Arrakark/Draco/hardware/pin_define.txt

#DEFINE FIRE_A 22
#DEFINE FIRE_B 23
#DEFINE FIRE_C 24
#DEFINE TEST_EN_A 25
#DEFINE TEST_EN_B 26
#DEFINE TEST_EN_C 27

#DEFINE LORA_NSS 28
#DEFINE SD_NSS 29

#DEFINE LVL_EN 36

#DEFINE SERVO1 49
#DEFINE SERVO2 48
#DEFINE SERVO3 47
#DEFINE SERVO4 46
#DEFINE SERVO5 45
#DEFINE SERVO6 44
#DEFINE SERVO7 43
#DEFINE SERVO8 42
#DEFINE SERVO9 41
#DEFUBE SERVI10 40

#DEFINE MAGNET_INT 62
#DEFINE ACCEL_INT1 63
#DEFINE ACCEL_INT2 64

DDRJ = DDRJ | B00110000;
//PORTJ = B10101000; // sets digital pins 7,5,3 HIGH
//camera not in Arduino ide; must use port manipulation to read and write camera values. Write functions for these plz.
//CAM_LED PJ3 
//CAM_PHOTO PJ4 
//CAM_PWR PJ5 

#DEFINE LED_RED 6
#DEFINE LED_YELLOW 7
#DEFINE LED_GREEN 8

#DEFINE LORA_RST 59
#DEFINE VBAT_1S 58
#DEFINE VBAT_2S 57
#DEFINE TEST_READ_C 56
#DEFINE TEST_READ_B 55
#DEFINE TEST_READ_A 54

#DEFINE LORA_INT 2
#DEFINE GPS_INT 3

//GPS is connected to Serial1 not Serial

#DEFINE TEST_STAND_DOUT 68
#DEFINE TEST_STAND_SCK 69
