Arrakark/Draco/hardware/DracoPowerBudget.xlsx

Project Draco Power Budget
Battery Rail
Component | Quantity | Current Draw (mA) | Total Current (mA) | Voltage (V) | Power (mW) | Notes
HV Servos | 10 | 1200.00 | 12000 | 8.4 | 100800
5.0v Rail | 1 | 475.86 | 475.8556548 | 8.4 | 3997.1875
Sum |  |  | 12475.86 |  | 104797.1875
5.0V Rail
Component | Quantity | Current Draw (mA) | Total Current (mA) | Voltage (V) | Power (mW) | Notes
Test Servo | 10 | 0 | 0 | 5 | 0 | If you were to plug test servos in
Atmega 2560 | 1 | 200 | 200 | 5 | 1000 | Main MCU
TXS010 | 1 | 1 | 1 | 5 | 5 | Level Shifter
SD Card | 1 | 100 | 100 | 5 | 500
3.3V Rail | 1 | 143.55 | 143.55 | 5 | 717.75
LEDs | 3 | 5 | 15 | 5 | 75
Camera | 1 | 150 | 150 | 6 | 900
Sum |  |  | 609.55 |  | 3197.75
3.3V Rail
Component | Quantity | Current Draw (mA) | Total Current (mA) | Voltage (V) | Power (mW) | Notes
RFM95HW | 1 | 100 | 100 | 3.3 | 330 | LORA Radio
SAM-M8Q | 1 | 67 | 67 | 3.3 | 221.1 | GPS
BMX055 | 1 | 6 | 6 | 3.3 | 19.8 | IMU
MS5607 | 1 | 1 | 1 | 3.3 | 3.3
Sum |  |  | 174 |  | 574.2
Notes
5V Imax is 3.5A
3.3V Imax is 1A
