Arrakark/Draco/(list of files, drawings)

Other design files:
hardware/Draco.dsn
