Arrakark/Draco/hardware/Draco.kicad_pcb

## KiCad design hardware/Draco.kicad_pcb (2018-03-10)

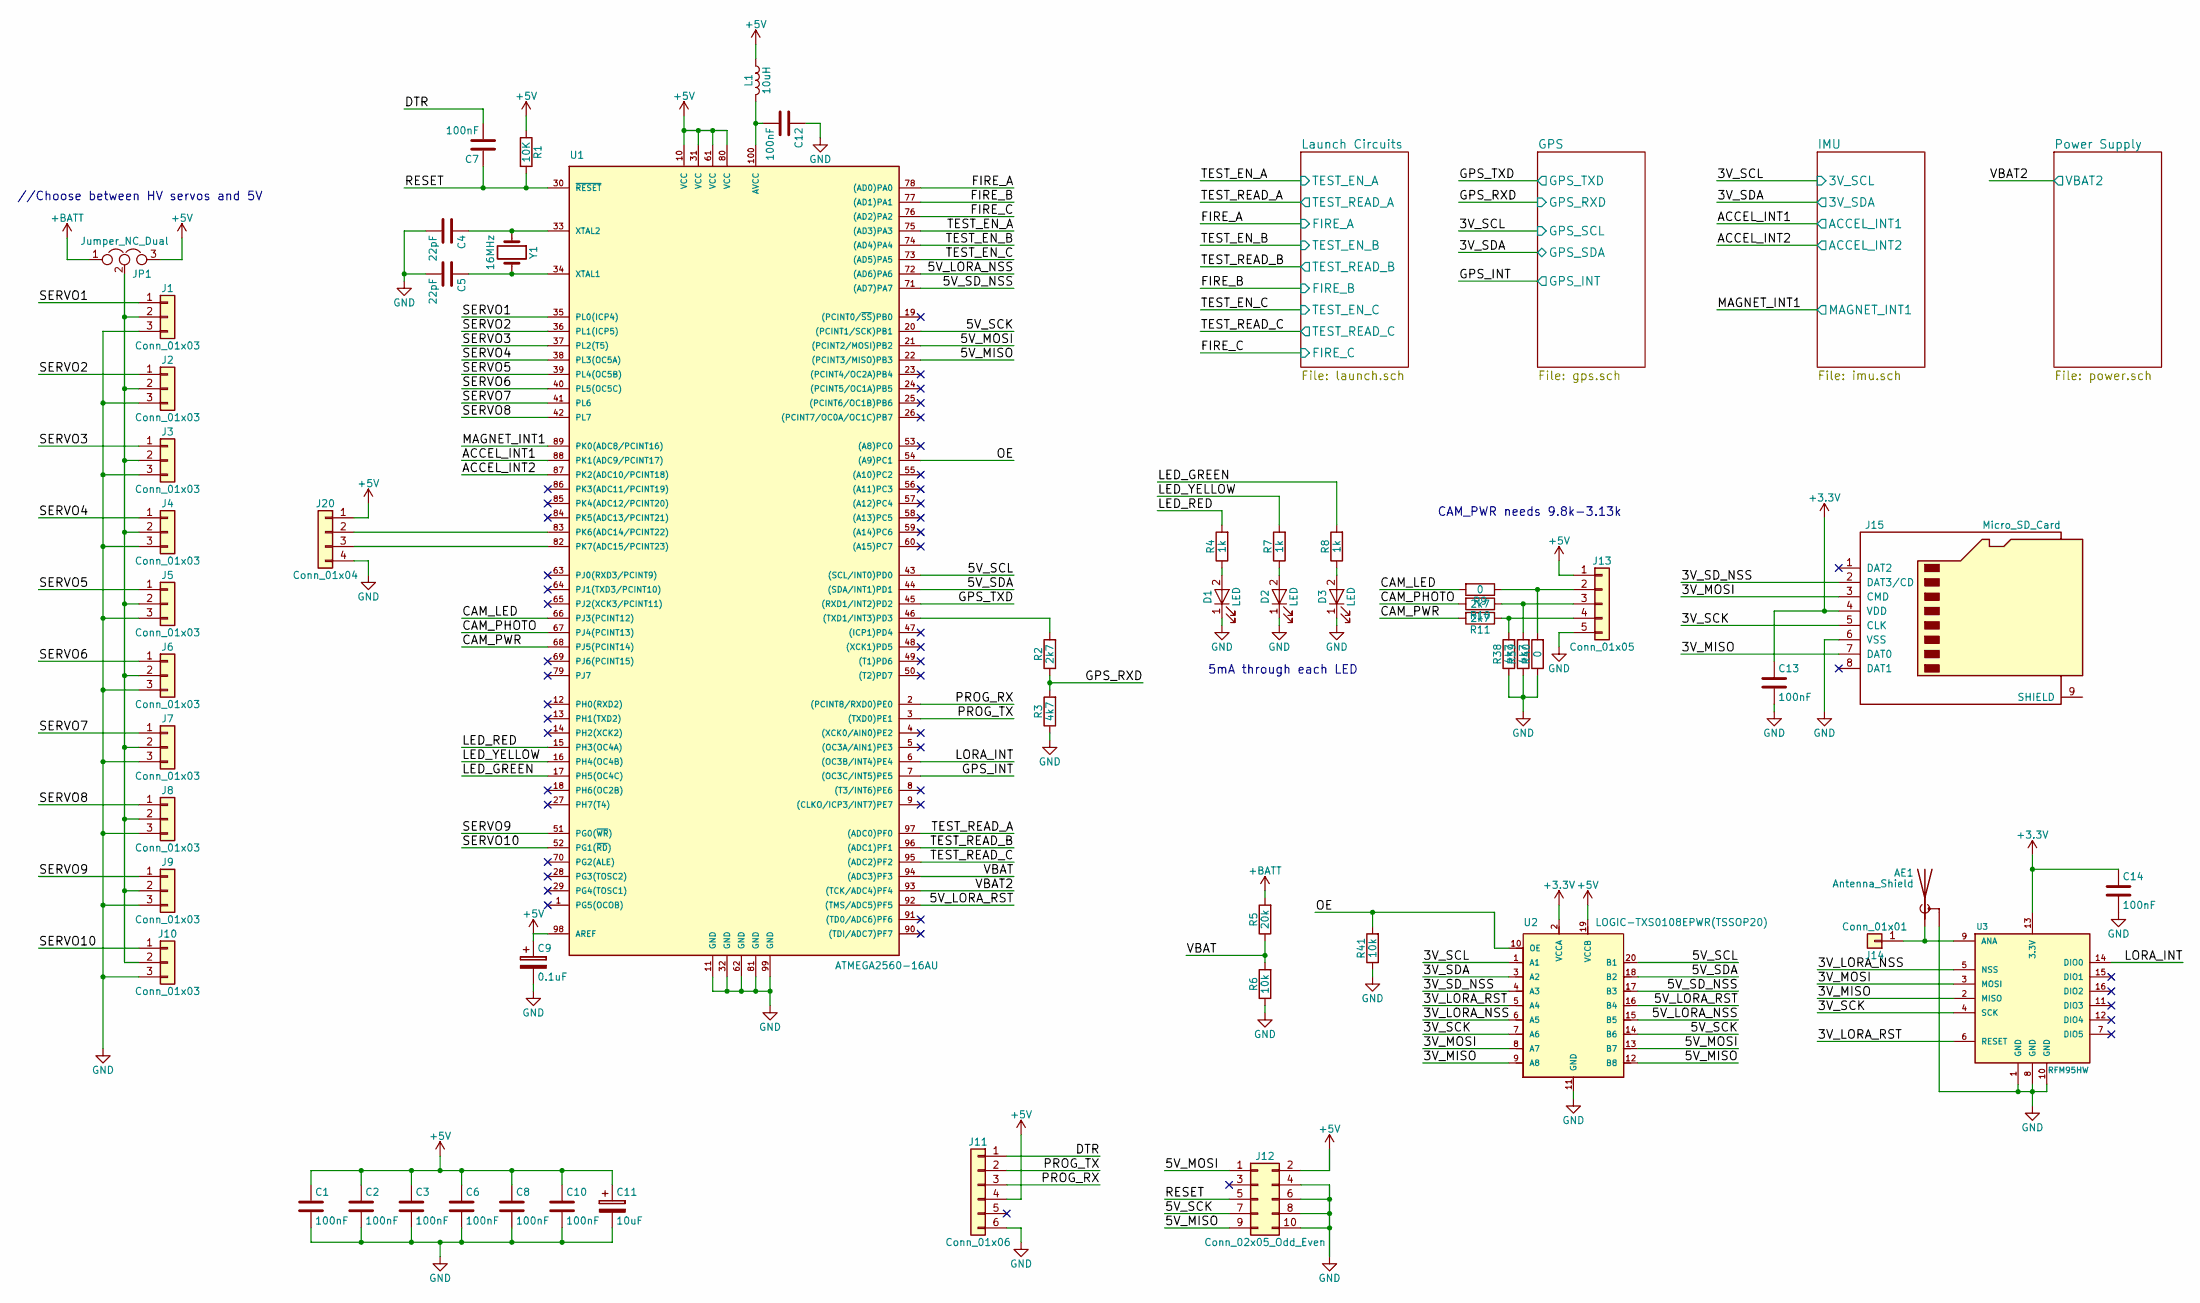
[picture p1: schematic Draco.sch]

Parts:
AE1: Antenna_Shield; U.FL-R-SMT
C1, C2, C3, C6, C7, C8, C10, C12, C13, C14: 100nF; C_0805
C4, C5: 22pF; C_0805
C9: 0.1uF; C_0805
C11: 10uF; C_0805
D1, D2, D3: LED; LED_0805
J1, J2, J3, J4, J5, J6, J7, J8, J9, J10: Conn_01x03; Pin_Header_Straight_1x03_Pitch2.54mm
J11: Conn_01x06; Socket_Strip_Straight_1x06_Pitch2.54mm
J12: Conn_02x05_Odd_Even; Pin_Header_Straight_2x05_Pitch2.54mm
J13: Conn_01x05; JST_XH_B05B-XH-A_05x2.50mm_Straight
J14: Conn_01x01; Pin_Header_Straight_1x01_Pitch2.54mm
J15: Micro_SD_Card; microSD_Card_Receptacle_Wuerth_693072010801
J20: Conn_01x04; JST_XH_B04B-XH-A_04x2.50mm_Straight
JP1: Jumper_NC_Dual; Pin_Header_Straight_1x03_Pitch2.54mm
L1: 10uH; L_0805
R1: 10K; R_0805
R2, R10, R11: 2k7; R_0805
R3, R38, R39: 4k7; R_0805
R4, R7, R8: 1k; R_0805
R5: 20k; R_0805
R6, R41: 10k; R_0805
R9, R40: 0; R_0805
U1: ATMEGA2560-16AU; TQFP-100_14x14mm_Pitch0.5mm
U2: LOGIC-TXS0108EPWR(TSSOP20); SSOP-20
U3: RFM95HW; Hopref_RFM9XW_SMD
Y1: 16MHz; Crystal_SMD_HC49-SD

Connections:
+5V: C1.1, C2.1, C3.1, C6.1, C8.1, C9.1, C10.1, C11.1, J11.4, J12.2, J13.1, J20.1, JP1.3, L1.1, R1.1, U1.10 (VCC), U1.31 (VCC), U1.61 (VCC), U1.80 (VCC), U1.98 (AREF), U2.19 (VCCB); also elsewhere on the board
+BATT: JP1.1, R5.2; also elsewhere on the board
/3V_LORA_NSS: U2.6 (A5), U3.5 (NSS)
/3V_LORA_RST: U2.5 (A4), U3.6 (RESET)
/3V_MISO: J15.7 (DAT0), U2.9 (A8), U3.2 (MISO)
/3V_MOSI: J15.3 (CMD), U2.8 (A7), U3.3 (MOSI)
/3V_SCK: J15.5 (CLK), U2.7 (A6), U3.4 (SCK)
/3V_SCL: U2.1 (A1); also elsewhere on the board
/3V_SDA: U2.3 (A2); also elsewhere on the board
/3V_SD_NSS: J15.2 (DAT3/CD), U2.4 (A3)
/5V_LORA_NSS: U1.72 ((AD6)PA6), U2.15 (B5)
/5V_LORA_RST: U1.92 ((TMS/ADC5)PF5), U2.16 (B4)
/5V_MISO: J12.9, U1.22 ((PCINT3/MISO)PB3), U2.12 (B8)
/5V_MOSI: J12.1, U1.21 ((PCINT2/MOSI)PB2), U2.13 (B7)
/5V_SCK: J12.7, U1.20 ((PCINT1/SCK)PB1), U2.14 (B6)
/5V_SCL: U1.43 ((SCL/INT0)PD0), U2.20 (B1)
/5V_SDA: U1.44 ((SDA/INT1)PD1), U2.18 (B2)
/5V_SD_NSS: U1.71 ((AD7)PA7), U2.17 (B3)
/ACCEL_INT1: U1.88 (PK1(ADC9/PCINT17)); also elsewhere on the board
/ACCEL_INT2: U1.87 (PK2(ADC10/PCINT18)); also elsewhere on the board
/CAM_LED: R9.2, U1.66 (PJ3(PCINT12))
/CAM_PHOTO: R10.2, U1.67 (PJ4(PCINT13))
/CAM_PWR: R11.2, U1.68 (PJ5(PCINT14))
/DTR: C7.2, J11.1
/FIRE_A: U1.78 ((AD0)PA0); also elsewhere on the board
/FIRE_B: U1.77 ((AD1)PA1); also elsewhere on the board
/FIRE_C: U1.76 ((AD2)PA2); also elsewhere on the board
/GPS_INT: U1.7 ((OC3C/INT5)PE5); also elsewhere on the board
/GPS_RXD: R2.1, R3.2; also elsewhere on the board
/GPS_TXD: U1.45 ((RXD1/INT2)PD2); also elsewhere on the board
/LED_GREEN: R8.2, U1.17 (PH5(OC4C))
/LED_RED: R4.2, U1.15 (PH3(OC4A))
/LED_YELLOW: R7.2, U1.16 (PH4(OC4B))
/LORA_INT: U1.6 ((OC3B/INT4)PE4), U3.14 (DIO0)
/MAGNET_INT1: U1.89 (PK0(ADC8/PCINT16)); also elsewhere on the board
/OE: R41.2, U1.54 ((A9)PC1), U2.10 (OE)
/PROG_RX: J11.3, U1.2 ((PCINT8/RXD0)PE0)
/PROG_TX: J11.2, U1.3 ((TXD0)PE1)
/RESET: C7.1, J12.5, R1.2, U1.30 (~RESET)
/SERVO1: J1.1, U1.35 (PL0(ICP4))
/SERVO2: J2.1, U1.36 (PL1(ICP5))
/SERVO3: J3.1, U1.37 (PL2(T5))
/SERVO4: J4.1, U1.38 (PL3(OC5A))
/SERVO5: J5.1, U1.39 (PL4(OC5B))
/SERVO6: J6.1, U1.40 (PL5(OC5C))
/SERVO7: J7.1, U1.41 (PL6)
/SERVO8: J8.1, U1.42 (PL7)
/SERVO9: J9.1, U1.51 (PG0(~WR~))
/SERVO10: J10.1, U1.52 (PG1(~RD~))
/TEST_EN_A: U1.75 ((AD3)PA3); also elsewhere on the board
/TEST_EN_B: U1.74 ((AD4)PA4); also elsewhere on the board
/TEST_EN_C: U1.73 ((AD5)PA5); also elsewhere on the board
/TEST_READ_A: U1.97 ((ADC0)PF0); also elsewhere on the board
/TEST_READ_B: U1.96 ((ADC1)PF1); also elsewhere on the board
/TEST_READ_C: U1.95 ((ADC2)PF2); also elsewhere on the board
/VBAT: R5.1, R6.2, U1.94 ((ADC3)PF3)
/VBAT2: U1.93 ((TCK/ADC4)PF4); also elsewhere on the board
GND: AE1.2 (Shield), C1.2, C2.2, C3.2, C4.2, C5.2, C6.2, C8.2, C9.2, C10.2, C11.2, C12.1, C13.2, C14.2, D1.1 (K), D2.1 (K), D3.1 (K), J1.3, J2.3, J3.3, J4.3, J5.3, J6.3, J7.3, J8.3, J9.3, J10.3, J11.6, J12.4, J12.6, J12.8, J12.10, J13.5, J15.6 (VSS), J20.4, R3.1, R6.1, R38.1, R39.1, R40.1, R41.1, U1.11 (GND), U1.32 (GND), U1.62 (GND), U1.81 (GND), U1.99 (GND), U2.11 (GND), U3.1 (GND), U3.8 (GND), U3.10 (GND); also elsewhere on the board
unnamed: AE1.1 (A), J14.1, U3.9 (ANA)
unnamed: C4.1, U1.33 (XTAL2), Y1.1
unnamed: C5.1, U1.34 (XTAL1), Y1.2
unnamed: C12.2, L1.2, U1.100 (AVCC)
unnamed: D1.2 (A), R4.1
unnamed: D2.2 (A), R7.1
unnamed: D3.2 (A), R8.1
unnamed: J1.2, J2.2, J3.2, J4.2, J5.2, J6.2, J7.2, J8.2, J9.2, J10.2, JP1.2
unnamed: J13.2, R9.1, R40.2
unnamed: J13.3, R10.1, R39.2
unnamed: J13.4, R11.1, R38.2
unnamed: J20.2, U1.83 (PK6(ADC14/PCINT22))
unnamed: J20.3, U1.82 (PK7(ADC15/PCINT23))
unnamed: R2.2, U1.46 ((TXD1/INT3)PD3)

Notes on the sheet:
//Choose between HV servos and 5V
5mA through each LED
CAM_PWR needs 9.8k-3.13k

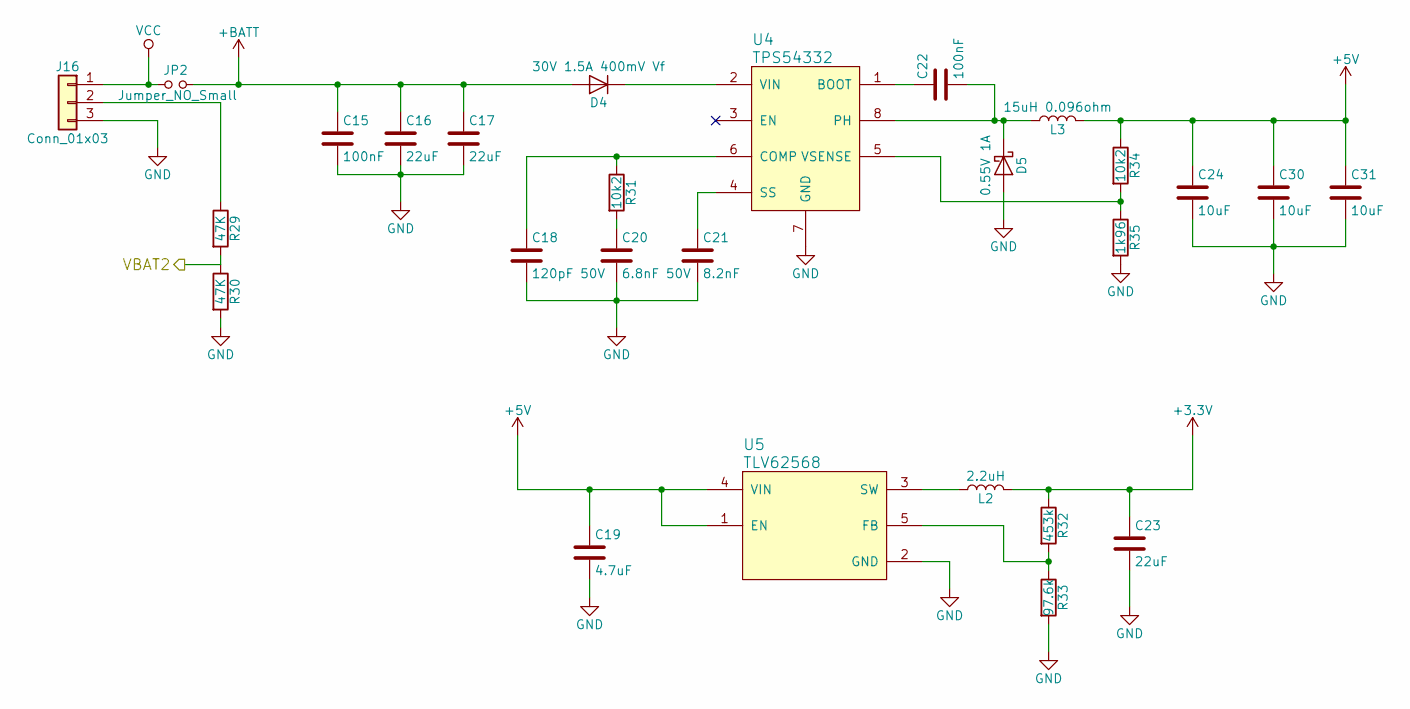
[picture p2: schematic power.sch]

Parts:
C15, C22: 100nF; C_0805
C16, C17, C23: 22uF; C_0805
C18: 120pF 50V; C_0805
C19: 4.7uF; C_0805
C20: 6.8nF 50V; C_0805
C21: 8.2nF; C_0805
C24, C30, C31: 10uF; C_0805
D4: 30V 1.5A 400mV Vf; D_SOD-323
D5: 0.55V 1A; D_SOD-123F
J16: Conn_01x03; JST_XH_S03B-XH-A_03x2.50mm_Angled
JP2: Jumper_NO_Small; Pin_Header_Straight_1x02_Pitch2.54mm
L2: 2.2uH; L_Taiyo-Yuden_NR-60xx
L3: 15uH 0.096ohm; L_Taiyo-Yuden_NR-60xx
R29, R30: 47K; R_0805
R31, R34: 10k2; R_0805
R32: 453k; R_0805
R33: 97.6k; R_0805
R35: 1k96; R_0805
U4: TPS54332; SOIC-8-1EP_3.9x4.9mm_Pitch1.27mm
U5: TLV62568; SOT-23-5

Connections:
+5V: C19.1, C24.1, C30.1, C31.1, L3.2, R34.1, U5.1 (EN), U5.4 (VIN); also elsewhere on the board
+BATT: C15.1, C16.1, C17.1, D4.2 (A), JP2.2; also elsewhere on the board
/VBAT2: R29.2, R30.1; also elsewhere on the board
GND: C15.2, C16.2, C17.2, C18.2, C19.2, C20.2, C21.2, C23.2, C24.2, C30.2, C31.2, D5.2 (A), J16.3, R30.2, R33.2, R35.2, U4.7 (GND), U4.9 (GND), U5.2 (GND); also elsewhere on the board
unnamed: C18.1, R31.1, U4.6 (COMP)
unnamed: C20.1, R31.2
unnamed: C21.1, U4.4 (SS)
unnamed: C22.1, U4.1 (BOOT)
unnamed: C22.2, D5.1 (K), L3.1, U4.8 (PH)
unnamed: D4.1 (K), U4.2 (VIN)
unnamed: J16.2, R29.1
unnamed: L2.1, U5.3 (SW)
unnamed: R32.2, R33.1, U5.5 (FB)
unnamed: R34.2, R35.1, U4.5 (VSENSE)
VCC: J16.1, JP2.1; also elsewhere on the board

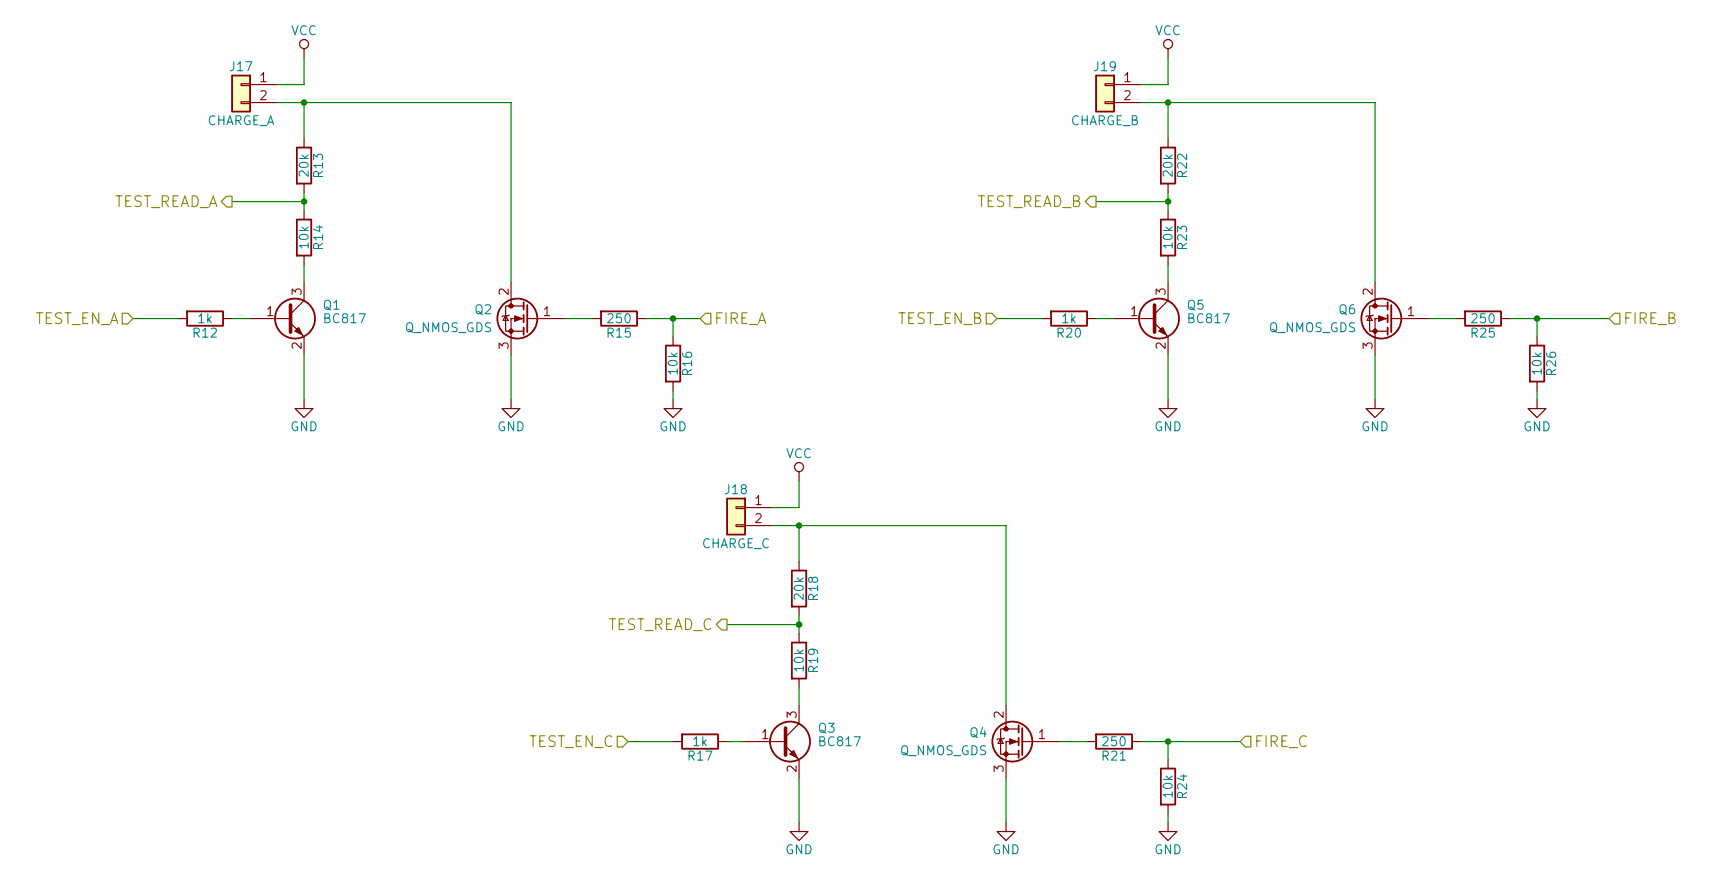
[picture p3: schematic launch.sch]

Parts:
J17: CHARGE_A; TerminalBlock_bornier-2_P5.08mm
J18: CHARGE_C; TerminalBlock_bornier-2_P5.08mm
J19: CHARGE_B; TerminalBlock_bornier-2_P5.08mm
Q1, Q3, Q5: BC817; SOT-23
Q2, Q4, Q6: Q_NMOS_GDS; TO-252-2
R12, R17, R20: 1k; R_0805
R13, R18, R22: 20k; R_0805
R14, R16, R19, R23, R24, R26: 10k; R_0805
R15, R21, R25: 250; R_0805

Connections:
/FIRE_A: R15.1, R16.1; also elsewhere on the board
/FIRE_B: R25.1, R26.1; also elsewhere on the board
/FIRE_C: R21.1, R24.1; also elsewhere on the board
/TEST_EN_A: R12.2; also elsewhere on the board
/TEST_EN_B: R20.2; also elsewhere on the board
/TEST_EN_C: R17.2; also elsewhere on the board
/TEST_READ_A: R13.2, R14.1; also elsewhere on the board
/TEST_READ_B: R22.2, R23.1; also elsewhere on the board
/TEST_READ_C: R18.2, R19.1; also elsewhere on the board
GND: Q1.2 (E), Q2.3 (S), Q3.2 (E), Q4.3 (S), Q5.2 (E), Q6.3 (S), R16.2, R24.2, R26.2; also elsewhere on the board
unnamed: J17.2, Q2.2 (D), R13.1
unnamed: J18.2, Q4.2 (D), R18.1
unnamed: J19.2, Q6.2 (D), R22.1
unnamed: Q1.1 (B), R12.1
unnamed: Q1.3 (C), R14.2
unnamed: Q2.1 (G), R15.2
unnamed: Q3.1 (B), R17.1
unnamed: Q3.3 (C), R19.2
unnamed: Q4.1 (G), R21.2
unnamed: Q5.1 (B), R20.1
unnamed: Q5.3 (C), R23.2
unnamed: Q6.1 (G), R25.2
VCC: J17.1, J18.1, J19.1; also elsewhere on the board

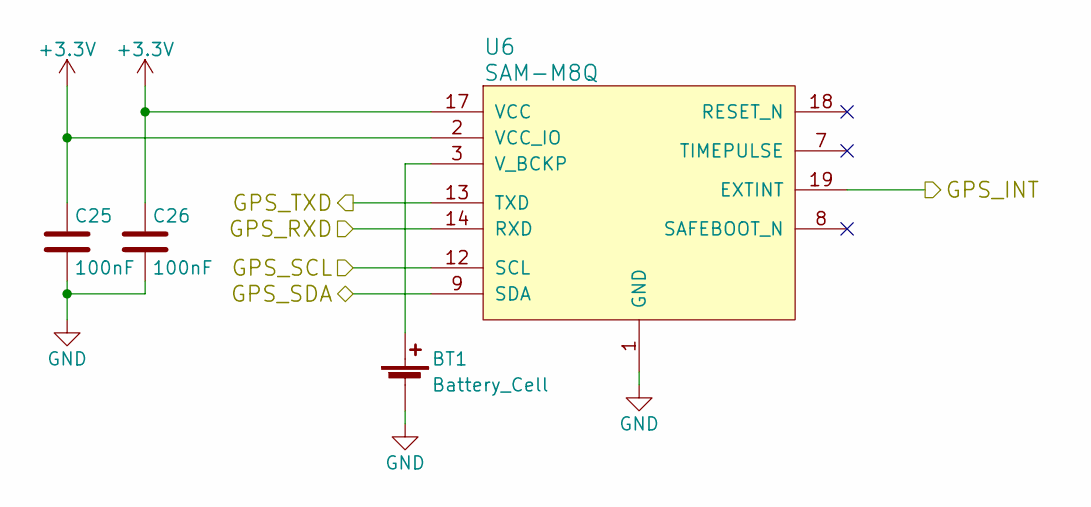
[picture p4: schematic gps.sch]

Parts:
BT1: Battery_Cell; Keystone_3000_1x12mm-CoinCell
C25, C26: 100nF; C_0805
U6: SAM-M8Q

Connections:
/3V_SCL: U6.12 (SCL); also elsewhere on the board
/3V_SDA: U6.9 (SDA); also elsewhere on the board
/GPS_INT: U6.19 (EXTINT); also elsewhere on the board
/GPS_RXD: U6.14 (RXD); also elsewhere on the board
/GPS_TXD: U6.13 (TXD); also elsewhere on the board
GND: BT1.2 (-), C25.2, C26.2, U6.1 (GND), U6.4 (GND), U6.5 (GND), U6.6 (GND), U6.10 (GND), U6.11 (GND), U6.15 (GND), U6.16 (GND), U6.20 (GND); also elsewhere on the board
unnamed: BT1.1 (+), U6.3 (V_BCKP)

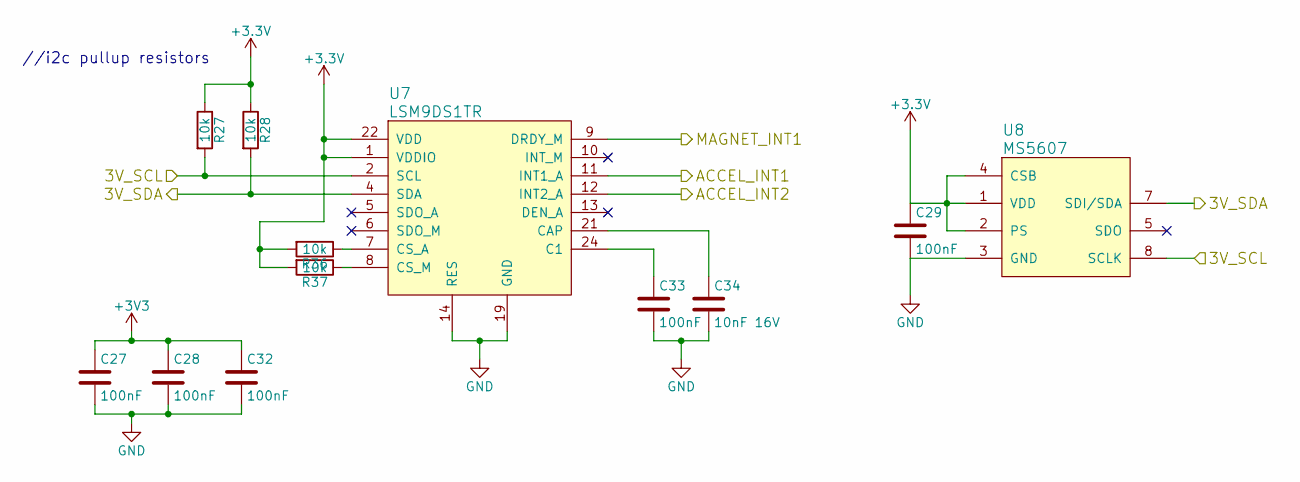
[picture p5: schematic imu.sch]

Parts:
C27, C28, C29, C32, C33: 100nF; C_0805
C34: 10nF 16V; C_0805
R27, R28, R36, R37: 10k; R_0805
U7: LSM9DS1TR‎; LGA-24L_3x3.5mm_Pitch0.43mm
U8: MS5607

Connections:
/3V_SCL: R27.2, U7.2 (SCL), U8.8 (SCLK); also elsewhere on the board
/3V_SDA: R28.2, U7.4 (SDA), U8.7 (SDI/SDA); also elsewhere on the board
/ACCEL_INT1: U7.11 (INT1_A); also elsewhere on the board
/ACCEL_INT2: U7.12 (INT2_A); also elsewhere on the board
/MAGNET_INT1: U7.9 (DRDY_M); also elsewhere on the board
GND: C27.2, C28.2, C29.2, C32.2, C33.2, C34.2, U7.14 (RES), U7.15 (RES), U7.16 (RES), U7.17 (RES), U7.18 (RES), U7.19 (GND), U7.20 (GND), U8.3 (GND); also elsewhere on the board
unnamed: C33.1, U7.24 (C1)
unnamed: C34.1, U7.21 (CAP)
unnamed: R36.1, U7.7 (CS_A)
unnamed: R37.1, U7.8 (CS_M)
unnamed: U8.5 (SDO), U8.6 (SDO)

Notes on the sheet:
//i2c pullup resistors

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
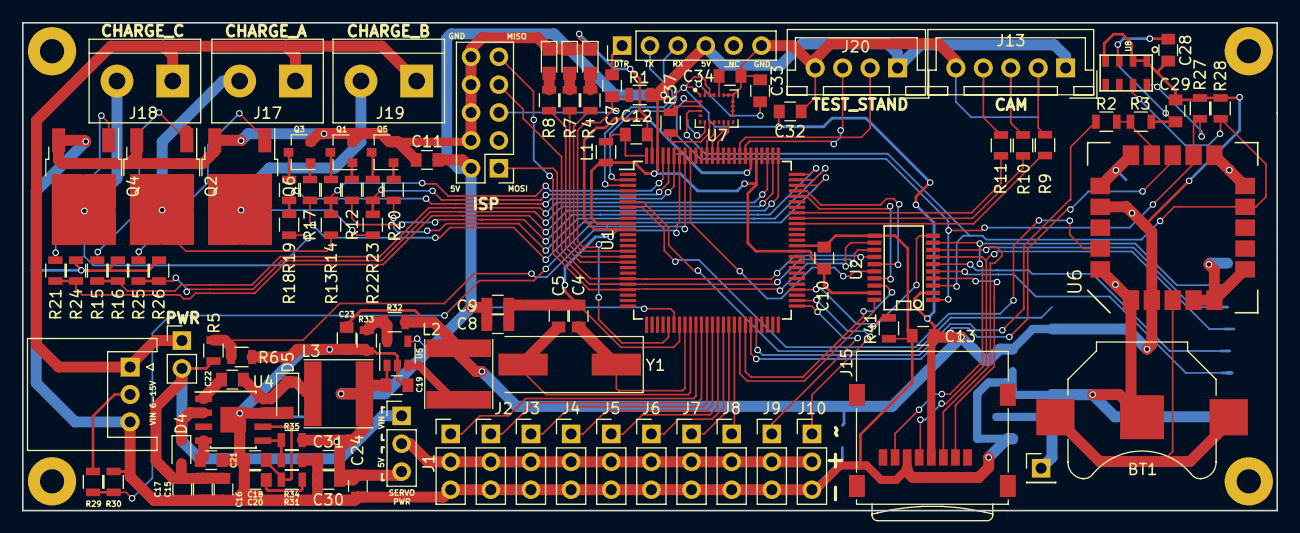
[picture p6: board Draco.kicad_pcb from above]

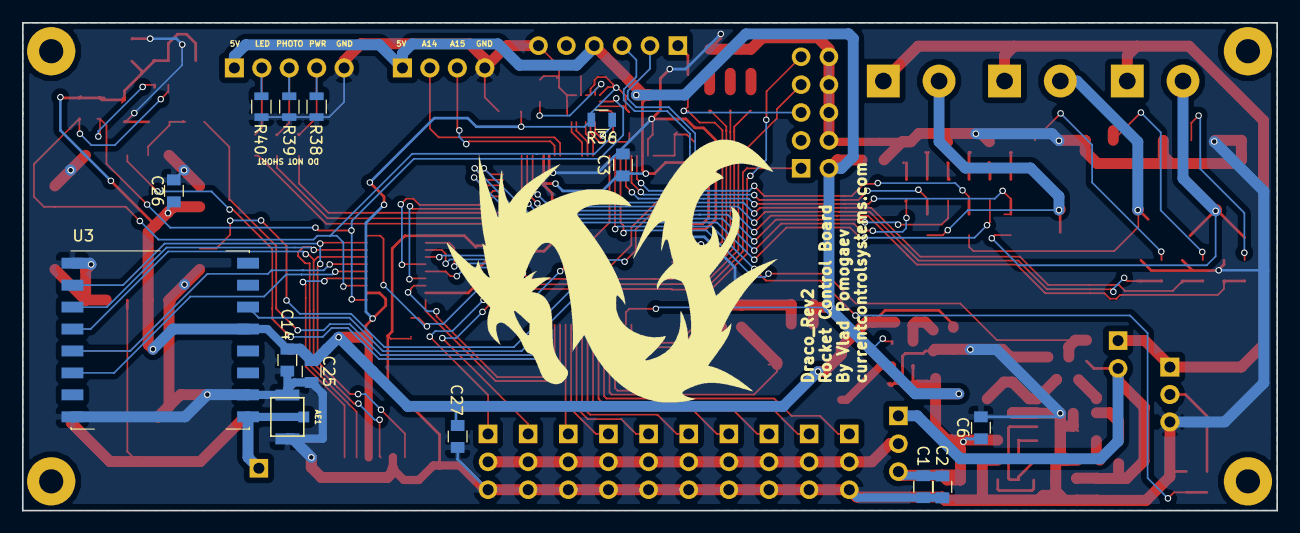
[picture p7: board Draco.kicad_pcb from below]

Board: 2 copper layers, 114.3 x 44.5 mm, 126 parts (14 on the bottom side), 102 nets.

Other parts of the board:
MH1, MH2, MH3, MH4: MountingHole_2.2mm_M2_Pad
