Arrakark/Draco/test_stand/Scale Calibration.xlsx

Reading | Real Weight (lbs) | Real Weight (kg)
-13920 | 2.5 | 1.13398
-28017 | 5 | 2.26796
-70947 | 12.5 | 5.6699
-42845 | 7.5 | 3.40194
-84318 | 15 | 6.80388
-98409 | 17.5 | 7.93786
-112280 | 20 | 9.07184
-126240 | 22.5 | 10.20582
-140248 | 25 | 11.3398
-153809 | 27.5 | 12.47378
-167898 | 30 | 13.60776
-181810 | 32.5 | 14.74174
-168067 | 30 | 13.60776
-182144 | 32.5 | 14.74174
-196092 | 35 | 15.87572
-210193 | 37.5 | 17.0097
-223769 | 40 | 18.14368
