Arrakark/Draco/(commit log)

2018-01-17 replaced the level-shifter
    [Draco.sch]
2018-01-18 added sd card
    [Draco.sch, gps.sch, imu.sch, launch.sch, power.sch]
2018-01-21 Did design review. Changed/confirmed voltage levels
    [Draco.sch, gps.sch, imu.sch, launch.sch, power.sch]
2018-01-22 Started Board layout
    [Draco.sch, gps.sch, imu.sch, launch.sch, power.sch]
2018-01-22 Finished charge layout
    [Draco.kicad_pcb, power.sch]
2018-01-23 Started board placement
    [Draco.kicad_pcb]
2018-01-23 Routed crystal; might not be permenant spot
    [Draco.kicad_pcb]
2018-01-23 Added parts list to power budget
    [DracoPowerBudget.xlsx]
2018-01-25 recalculated power and added new supply schem.
    [DracoPowerBudget.xlsx, power.sch]
2018-01-25 pushed new psu to pcb
    [Draco.kicad_pcb, Draco.sch, gps.sch, imu.sch, launch.sch, power.sch]
2018-01-25 Doing PCB Layout
    [Draco.kicad_pcb]
2018-01-25 moved charge module, routed lots of stuff
    [Draco.kicad_pcb, Draco.sch, gps.sch, imu.sch, launch.sch, power.sch]
2018-01-25 moving blocks around
    [Draco.kicad_pcb]
2018-01-26 Routed 50%
    [Draco.kicad_pcb, Draco.sch, _saved_Draco.sch, gps.sch, imu.sch, launch.sch, power.sch]
2018-01-26 Routed 60%
    [Draco.kicad_pcb, _saved_Draco.sch]
2018-01-26 Backtracked to 30%
    [Draco.kicad_pcb]
2018-01-27 Finished left side
    [Draco.kicad_pcb, Draco.sch, _saved_Draco.sch, _saved_imu.sch]
2018-01-28 80% done routing
    [Draco.kicad_pcb, _saved_Draco.sch]
2018-01-28 Adding bypass capacitors
    [Draco.kicad_pcb, Draco.sch, _saved_Draco.sch, imu.sch]
2018-01-28 Added logo files and BOM
    [DigikeyBOM.csv, Draco_bom_.csv]
2018-01-28 Finished preliminary layout
    [Draco.kicad_pcb]
2018-01-29 Halfway Done Labeling
    [Draco.kicad_pcb]
2018-01-29 Done reogrinizing labels
    [Draco.kicad_pcb]
2018-01-29 Added dragon
    [Draco.kicad_pcb]
2018-01-29 Starting design review
    [Draco.kicad_pcb]
2018-01-29 Added camera resistor divider
    [Draco.csv, Draco.kicad_pcb, Draco.sch, gps.sch, imu.sch, launch.sch, power.sch]
2018-01-30 work review
    [Draco.kicad_pcb, Draco.sch, gps.sch, imu.sch, launch.sch, power.sch]
2018-01-30 Added camera power
    [Draco.kicad_pcb, Draco.sch, gps.sch, imu.sch, launch.sch, power.sch]
2018-01-30 Added logo again because the dragon keeps dissapearing
    [Draco.kicad_pcb]
2018-01-30 Figured out where the dragon goes
    [Draco.kicad_pcb]
2018-01-30 Added website
    [Draco.kicad_pcb]
2018-01-30 Added GERBERS
    [Draco-B.Cu.gbr, Draco-B.Mask.gbr, Draco-B.SilkS.gbr, Draco-Edge.Cuts.gbr, Draco-F.Cu.gbr, Draco-F.Mask.gbr, Draco-F.SilkS.gbr, Draco.drl]
2018-01-31 Fixed MOSFET pinout
    [Draco-B.Cu.gbr, Draco-B.Mask.gbr, Draco-B.Paste.gbr, Draco-B.SilkS.gbr, Draco-Edge.Cuts.gbr, Draco-F.Cu.gbr, Draco-F.Paste.gbr, Draco-F.SilkS.gbr]
2018-01-31 Fixed MOSFET ground plane
    [Draco-B.Cu.gbr, Draco-B.Mask.gbr, Draco-B.Paste.gbr, Draco-B.SilkS.gbr, Draco-Edge.Cuts.gbr, Draco-F.Cu.gbr, Draco-F.Mask.gbr, Draco-F.Paste.gbr]
2018-02-10 Fixed unconnected pins and finished pin_define.txt
    [Draco.sch, gps.sch, imu.sch, launch.sch, power.sch]
2018-02-25 moved hardware to hardware folder
    [DigikeyBOM.csv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]
2018-03-05 added scale calibration
    [Scale Calibration.xlsx]
2018-03-10 Adding libraries
    [Draco.kicad_pcb]
2018-03-15 added timer
